AnvithPothula/HalfLifeWeek3-Music/pictures/Final-PCB.png

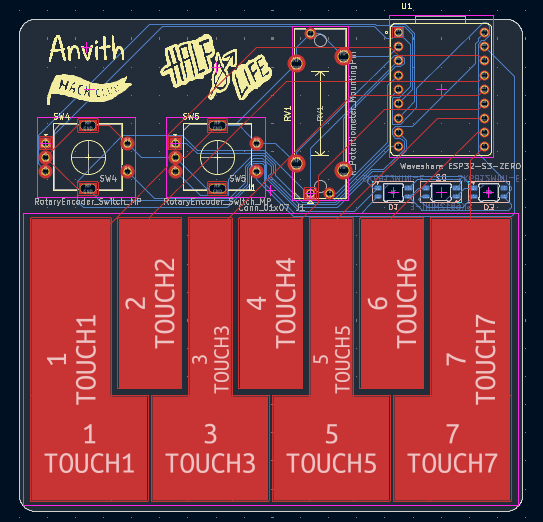
pictures/Final-PCB.png
