AnvithPothula/HalfLifeWeek3-Music/BOM.csv

Item | Qty | Supplier | Cost/item | Total Cost | link
ESP32-S3-Zero | 1 | AliExpress | $4.32 | $4.32 | https://www.aliexpress.us/item/3256807949476561.html
EC11 Rotary Encoder 20mm (5-pack) | 1 | AliExpress | $3.36 | $3.36 | https://www.aliexpress.us/item/3256808530463909.html
SK6812 MINI-E NeoPixels (20-pack) | 1 | AliExpress | $2.54 | $2.54 | https://www.aliexpress.us/item/3256805007401420.html
45mm Slide Potentiometer B10K (5-pack) | 1 | AliExpress | $5.13 | $5.13 | https://www.aliexpress.us/item/3256808872395865.html
PCB | 1 | JLCPCB | $4.00 | $4.00 | https://jlcpcb.com/
Estimated total shipping | 1 |  |  | $9.62
