AnvithPothula/HalfLifeWeek3-Music/midi-keypad/production/bom.csv

Designator | Footprint | Quantity | Value | LCSC Part #
D1, D2, D3 | LED_SK6812MINI-E_3.2x2.8mm_P1.5mm_ReverseMount | 3 | SK6812MINI-E
J1 | Capacitive Keys_7 | 1 | Conn_01x07
RV1 | Potentiometer_Bourns_PTA1543_Single_Slide | 1 | R_Potentiometer_MountingPin
SW4, SW5 | RotaryEncoder_Alps_EC11E-Switch_Vertical_H20mm | 2 | RotaryEncoder_Switch_MP
U1 | Waveshare ESP32-S3-Zero | 1 | Waveshare ESP32-S3-ZERO
