AnvithPothula/HalfLifeWeek3-Music/midi-keypad/midi-keypad.kicad_pcb

## KiCad design midi-keypad/midi-keypad.kicad_pcb (2026-11-10)

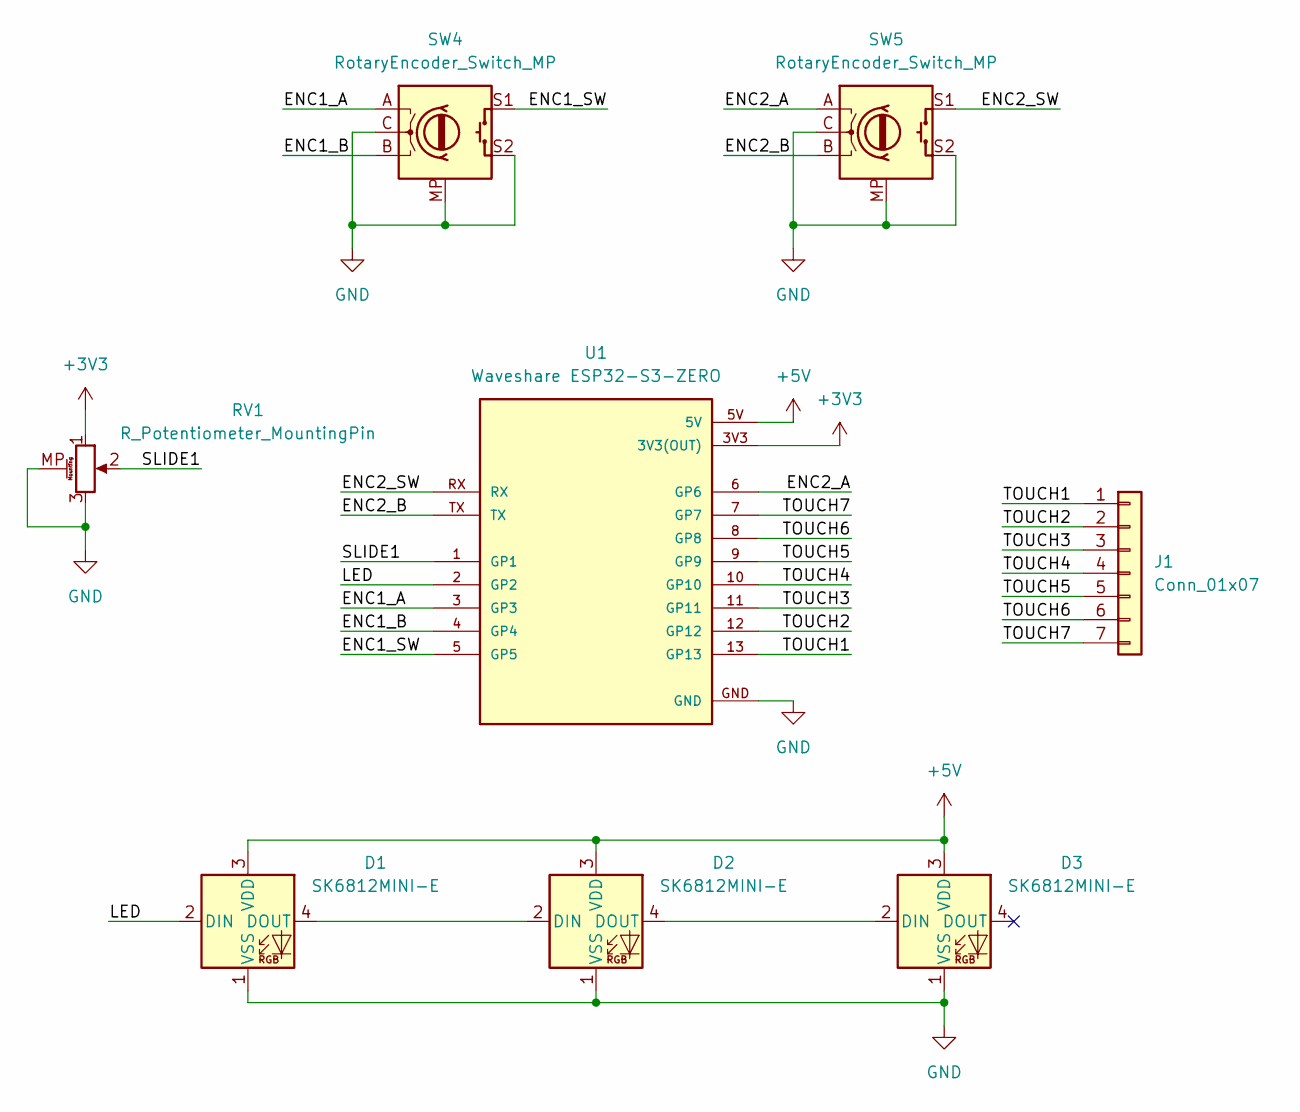
[picture p6: schematic midi-keypad.kicad_sch]

Parts:
D1, D2, D3: SK6812MINI-E; LED_SK6812MINI-E_3.2x2.8mm_P1.5mm_ReverseMount
J1: Conn_01x07; Capacitive Keys_7
RV1: R_Potentiometer_MountingPin; Potentiometer_Bourns_PTA1543_Single_Slide
SW4, SW5: RotaryEncoder_Switch_MP; RotaryEncoder_Alps_EC11E-Switch_Vertical_H20mm
U1: Waveshare ESP32-S3-ZERO; Waveshare ESP32-S3-Zero; PARTREV NA

Connections:
+3V3: RV1.1, U1.3V3 (3V3(OUT))
+5V: D1.3 (VDD), D2.3 (VDD), D3.3 (VDD), U1.5V
/ENC1_A: SW4.A, U1.3 (GP3)
/ENC1_B: SW4.B, U1.4 (GP4)
/ENC1_SW: SW4.S1, U1.5 (GP5)
/ENC2_A: SW5.A, U1.6 (GP6)
/ENC2_B: SW5.B, U1.TX
/ENC2_SW: SW5.S1, U1.RX
/LED: D1.2 (DIN), U1.2 (GP2)
/SLIDE1: RV1.2, U1.1 (GP1)
/TOUCH1: J1.1, U1.13 (GP13)
/TOUCH2: J1.2, U1.12 (GP12)
/TOUCH3: J1.3, U1.11 (GP11)
/TOUCH4: J1.4, U1.10 (GP10)
/TOUCH5: J1.5, U1.9 (GP9)
/TOUCH6: J1.6, U1.8 (GP8)
/TOUCH7: J1.7, U1.7 (GP7)
GND: D1.1 (VSS), D2.1 (VSS), D3.1 (VSS), RV1.3, RV1.MP (MountPin), SW4.C, SW4.MP, SW4.S2, SW5.C, SW5.MP, SW5.S2, U1.GND
unnamed: D1.4 (DOUT), D2.2 (DIN)
unnamed: D2.4 (DOUT), D3.2 (DIN)

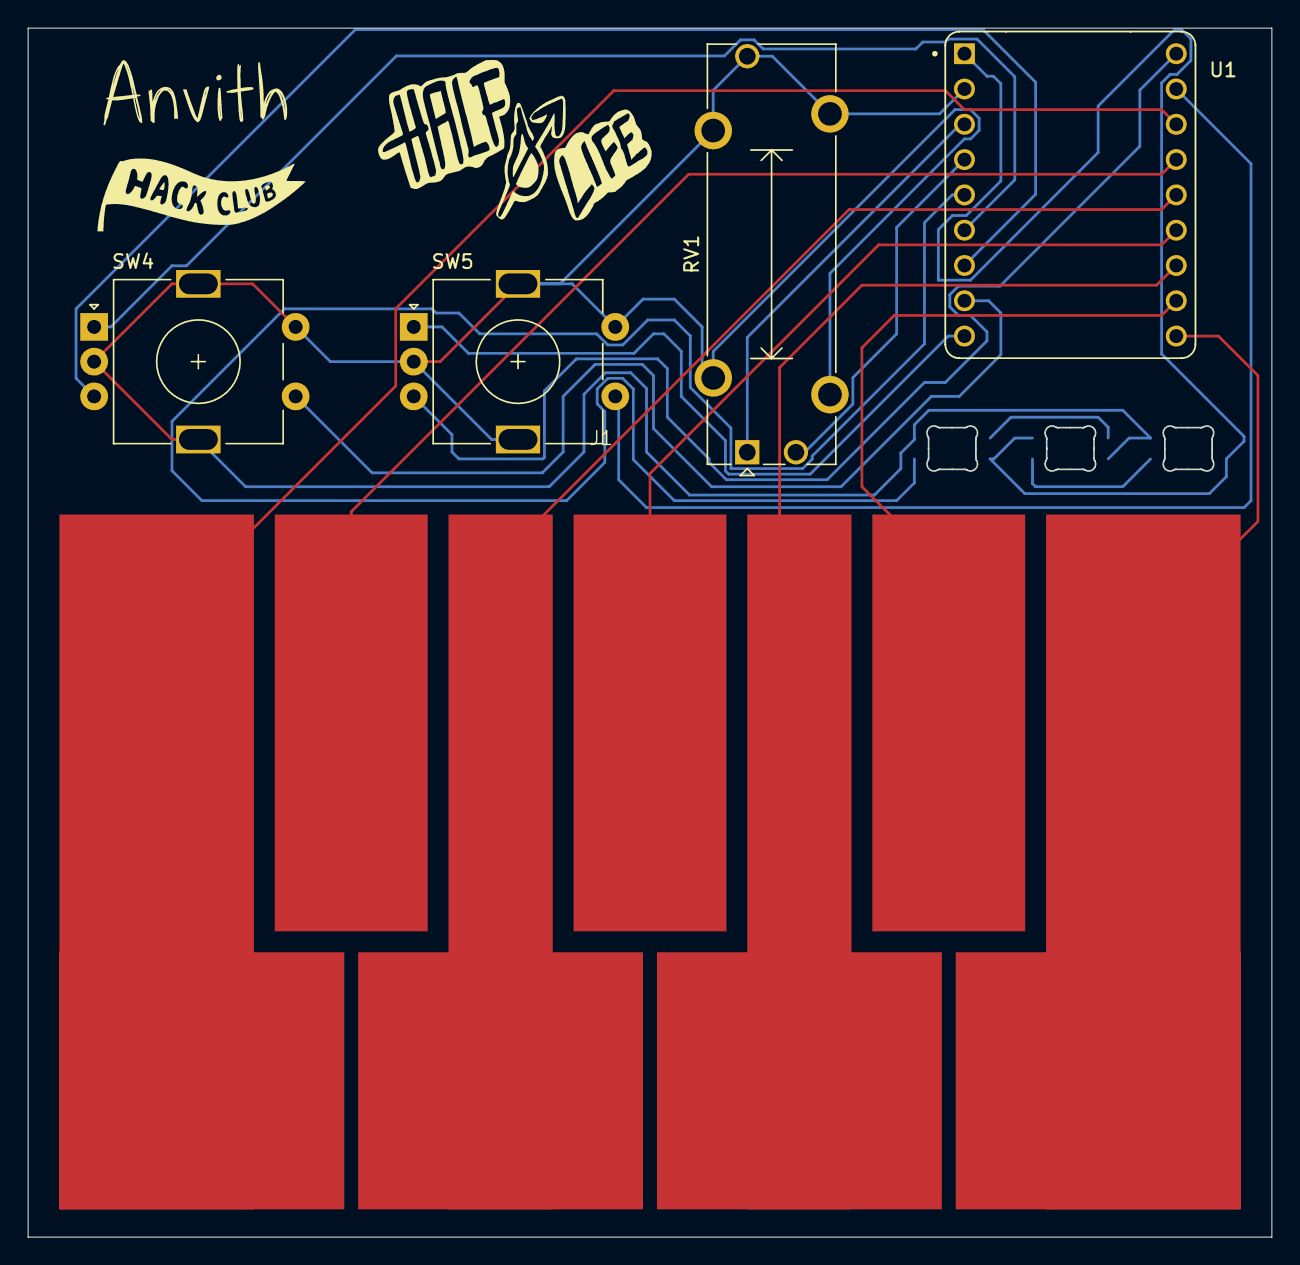
[picture p7: board midi-keypad.kicad_pcb from above]

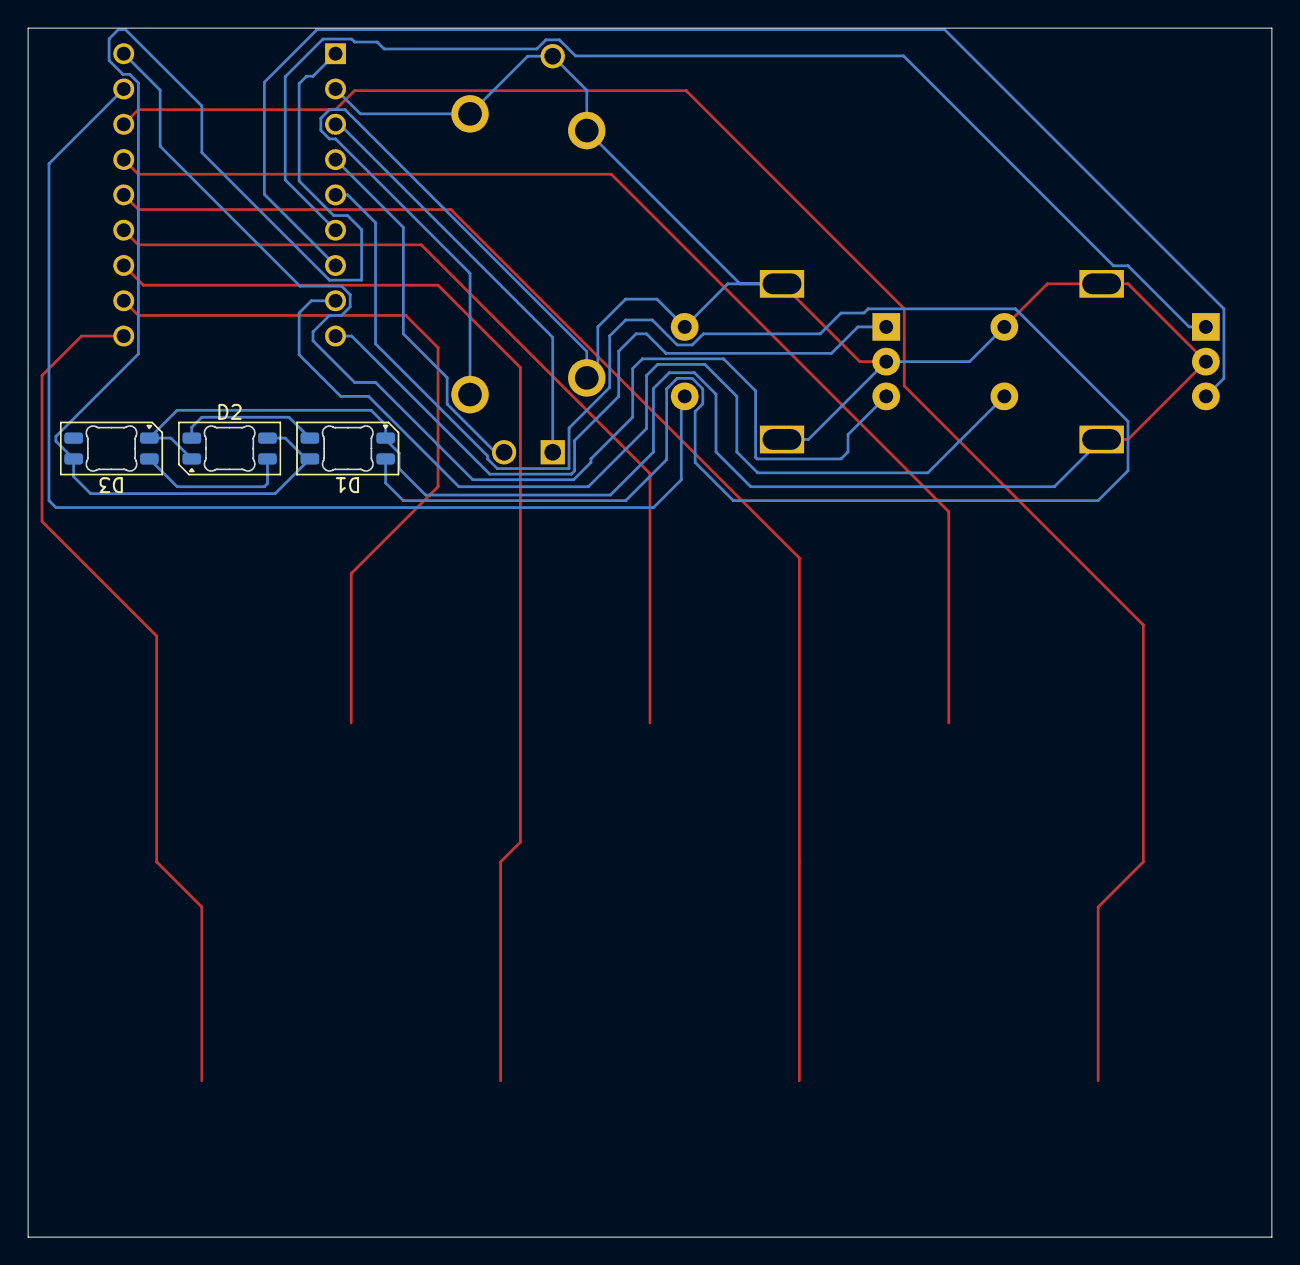
[picture p8: board midi-keypad.kicad_pcb from below]

Board: 2 copper layers, 89.5 x 87.0 mm, 8 parts (3 on the bottom side), 20 nets.
