AnvithPothula/HalfLifeWeek3-Music/JOURNAL.md

# Midi Keyboard: devlog

<!-- Generated by Half Life from project cmvfc8oy8004q01pordum604s. Edits here are overwritten on the next sync. -->
<!-- Generated: 2026-10-26T01:55:53.151Z -->

> [!NOTE]
> This devlog is mirrored from [Half Life](https://halflife.hackclub.com) ([open the project](https://halflife.hackclub.com/projects/cmvfc8oy8004q01pordum604s)). Editing it here will not change the platform's copy, and the next sync overwrites this file.

> I followed the guide to create the MIDI keypad. However, I made some changes. I added a second encoder, and since I decided to use both encoders clicking functionalities, I had to remove the low-profile switches and a slider to make room on the ESP32. The remaining slider is used for volume, the first encoder for changing octaves, and the second encoder for adding a modulation effect.

| Week | Tier | Hours logged | Entries |
| --- | --- | --- | --- |
| Week 3 | Tier 1 | 14h | 3 |

## Contents

1. [2026-10-24: In this session, I finished the schematic, added the footprints (except for the keypads), and imported it into the PCB editor. This is how my schematic looks right now:](#2026-10-24-in-this-session-i-finished-the-schematic-added-th)
2. [2026-10-25: I finished the PCB. Next session I will do all of the firmware and software stuff. Here is how the final PCB looks:](#2026-10-25-i-finished-the-pcb-next-session-i-will-do-all-of-)
3. [2026-10-25: Last session, I finished the PCB, so this session I wanted to add the software changes. The 2 changes I wanted to do was have one of my encoders change the octave, and the other add a modulation effec](#2026-10-25-last-session-i-finished-the-pcb-so-this-session-i)

## Design

### 2026-10-24: In this session, I finished the schematic, added the footprints (except for the keypads), and imported it into the PCB editor. This is how my schematic looks right now:

**3h**

In this session, I finished the schematic, added the footprints (except for the keypads), and imported it into the PCB editor. This is how my schematic looks right now:

Screenshot 2026-10-24 at 6.06.17 PM

Instead of going with the guide, I decided to do something a little different. I decided to add a second encoder, and use both of the encoder's switches. Since I didn't have enough room on the ESP32, I got rid of the low-profile switches and a slider. The remaining slider will be used to control the volume. For the first encoder, it will control the octaves, and the second octave will be a modulation wheel. The switches will reset the octave/mod effect. These are my footprints:

Screenshot 2026-10-24 at 6.13.05 PM

And finally this is how it looks like in the PCB editor (without the keys):

Screenshot 2026-10-24 at 6.14.59 PM

I spent a lot of the time on the schematic and thinking on what parts I should sacrifice for the second encoder.

### 2026-10-25: I finished the PCB. Next session I will do all of the firmware and software stuff. Here is how the final PCB looks:

**6h**

I finished the PCB. Next session I will do all of the firmware and software stuff. Here is how the final PCB looks:

Screenshot 2026-10-24 at 9.40.49 PM

It is similar to the guide, however I changed it by adding a second encoder. Since I did that and also am using their switch functionalities, I had to remove the 3 low-profile switches and one slider to make room on the ESP32.

Now, onto what I did. In the previous session I finished the schematic, so the first thing I did this session was create the footprint for the keys. This is what I ended up with (similar to the guide's, since I lke the piano keys style they used):

Screenshot 2026-10-24 at 7.19.43 PM

After moving everything around, this is the layout I settled with:

Screenshot 2026-10-24 at 7.47.14 PM

Wiring everything up took the longest time, especially with the LEDs. After spending a long time attempting to wire it up, I think it might have been impossible. However, I got through this by flipping D1 and D3 upside down. It still took a while but this is the final result of the wiring:

Screenshot 2026-10-24 at 10.29.25 PM

Screenshot 2026-10-24 at 10.29.37 PM

Screenshot 2026-10-24 at 10.29.46 PM

Finally, I added a design to the front silkscreen (you can see it from the previous images). I decided to go with something simple, since there wasn't much room on the front:

Screenshot 2026-10-24 at 9.22.41 PM

After that, I ended the session with downloading the gerber files.

### 2026-10-25: Last session, I finished the PCB, so this session I wanted to add the software changes. The 2 changes I wanted to do was have one of my encoders change the octave, and the other add a modulation effec

**5h**

Last session, I finished the PCB, so this session I wanted to add the software changes. The 2 changes I wanted to do was have one of my encoders change the octave, and the other add a modulation effect. The other change is that I wanted the neopixels to indicate what octave the keys were in, and also flash when a key was pressed.

I started by importing the USBMIDI and Adafruit_NeoPixel libraries so my computer recognizes the ESP32-S3-Zero as a native MIDI device. I mapped the pins, using TX and RX for the second encoder so I wouldn't have to solder the tiny pads underneath the board. I also created a touchPlaying array to remember which exact note each key is playing. That way, if I shift octaves while holding down a key, the board still knows which original note to turn off when I let go.

Screenshot 2026-10-25 at 8.41.09 PM

Since capacitive touch pads don't click like a normal switch, I wrote updateLEDs() to give me visual feedback. If any key is held down, the NeoPixels flash bright white so I know my tap registered. When no keys are pressed, the LEDs show my current octave (green for the default middle octave (0), cooler blues for lower octaves (-1 to -4), and warmer yellow-to-red colors for higher octaves (+1 to +4)).

Screenshot 2026-10-25 at 8.41.00 PM

In setup(), I enabled internal pull-up resistors (INPUT_PULLUP) on the encoder pins so the board didn't need extra physical resistors on the PCB. Because bare copper pads can have slightly different capacitance depending on the environment, I had the board take 16 readings per key on boot and average them into a baseline. Calibrating on startup prevents false triggers without me having to hardcode sensitivity numbers.

Screenshot 2026-10-25 at 8.40.50 PM

At the top of loop(), the code reads my first encoder to shift octaves. I clamped the shift between -4 and +4 so the math stays within valid MIDI limits, and added a 50ms debounce check on the encoder's click button so pressing it resets me back to the middle octave (0).

Screenshot 2026-10-25 at 8.40.19 PM

Next, the code reads my second encoder, which I mapped to MIDI CC 1 (Modulation Wheel) to add vibrato or synth effects. Turning a knob by 1 step from 0 to 127 takes way too many turns, so I made each click change the value by 4 for faster scrolling. Just like the first encoder, clicking the knob down instantly resets the modulation effect back to 0.

Screenshot 2026-10-25 at 8.40.28 PM

Finally, the loop scans the 7 touch keys and the volume slider. A key triggers if its reading jumps 25% above its startup baseline, shifting the base note by 12 semitones per octave and clamping it to the 0–127 MIDI range. For the slider, I scaled the 12-bit analog reading (0–4095) down to a 7-bit MIDI value (0–127) for Main Volume (CC 7), and made it only send updates when the value changes by more than 1 so electrical noise doesn't spam my computer with MIDI data.

Screenshot 2026-10-25 at 8.40.36 PM
