AnvithPothula/HalfLifeWeek3-Music/(commit log)

2026-10-25 Finished PCB
2026-11-02 Added BOM to README
2026-11-10 Updated BOM
